King0fBrains/nds-automation-test/img/gui.png

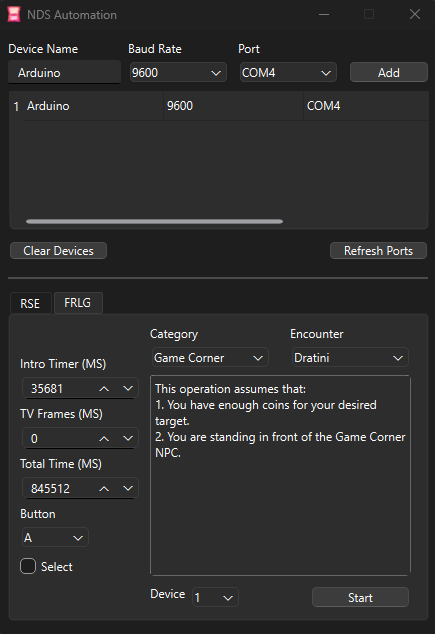
img/gui.png
