King0fBrains/nds-automation-test/img/Straypins.png

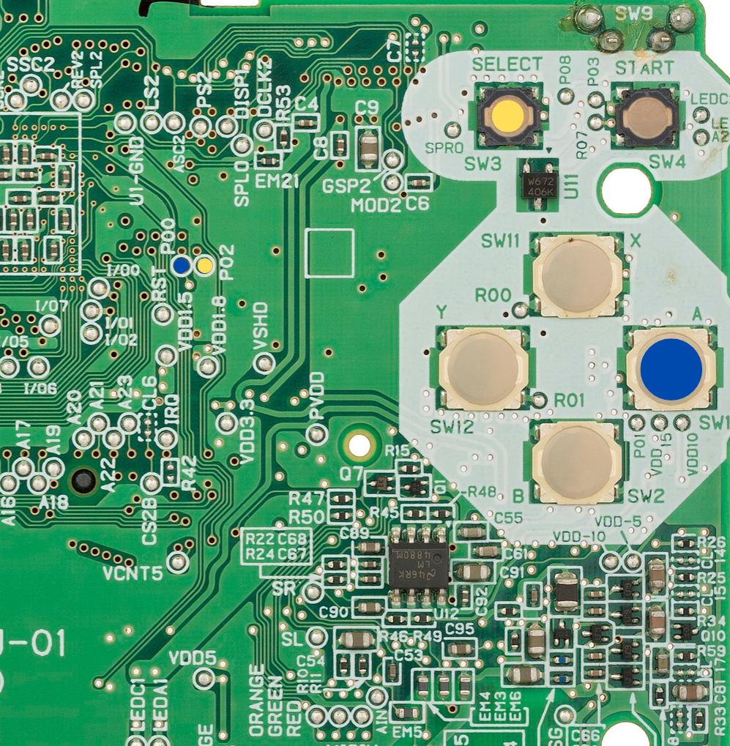
img/Straypins.png
