King0fBrains/nds-automation-test/img/Test-Pin-Map.png

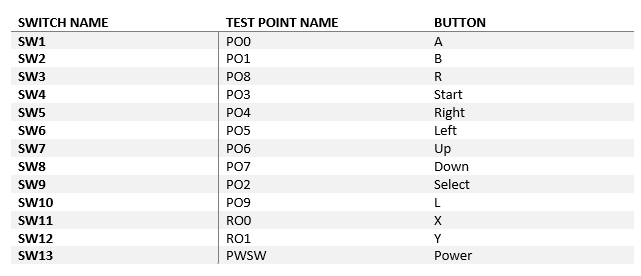
img/Test-Pin-Map.png
