King0fBrains/nds-automation-test/(commit log)

2024-06-17 Serial print logging
2024-06-19 Moved power pin macro to header and created a macro for converting MS to US
2024-06-19 Seperated out functions into blocks. Intro timer is seperate for reeusability. Changed timing checks to use while loops. Added comments for important functions
2024-06-19 Added `rebootConsole()` function back to header for testing
    [console.h]
2024-06-20 Use the correct time function
    [console.cpp]
2024-06-20 Fix grab ace sequence and clear looptimer if not empty
    [frlg.cpp]
2024-06-20 Add function to reboot console and get into the NDS Menu
    [frlg.cpp]
2024-06-21 Fixed console reboot/power logic. Tested and works
    [console.cpp, frlg.cpp, gen3.ino]
