King0fBrains/nds-automation-test/(notices)

Notices in the files:
README.md:
License: GPL v3
